dspl1236/TeensyEprom/schematics/audi90_teensy_v4.html

// ECU INTERFACE PROJECT · REV 0.4

# AUDI 90 2.6L STROKER // TEENSY 4.1

443 906 022 HITACHI · SPARTAN 3 LITE OEM + LSU ADV · PARALLEL BUS EMULATION + SENSOR EXPANSION

REV 0.4 — MAF STRATEGY UPDATE ▲ MAF: PHASE 1 FREQ INTERCEPT → PHASE 2 VW MK4 1.8T ANALOG ▲ HOUSING: VR6/225 70MM BILLET UNIT (SOURCING) ▲ FIRMWARE: DUAL-PHASE SENSOR-AGNOSTIC MAF ARCHITECTURE ▲ BOM: MAF SENSOR + HOUSING ADDED

Wiring Schematic

Power Regulation

Signal Intercepts

UART + Firmware

Breadboard Build

BOM + Buy Links

EPROM Bus → FlexIO

D0–D7Data bus (8-bit)Pins 2–9

A0–A7Address lowPins 10–17

A8–A15Address highPins 18–25

A16Address MSBPin 26

/OEOutput enablePin 27

/CEChip enablePin 28

LEVEL SHIFT: All 28 lines via 74HCT245 ×3. Data bus is bidirectional — DIR pin controlled by /OE state. Address + control lines are unidirectional ECU→Teensy.

Spartan 3 Lite OEM → SERIAL1 UPDATED

TXSpartan TX out (5V)10k/20k div → Teensy RX pin 0

RXSpartan RX in (5V)Teensy TX pin 1 direct ✓

12VController powerSwitched IGN + 5A fuse

HTR GNDLSU heater groundBattery − DEDICATED

SIG GNDSignal groundSignal GND rail

⚠ CRITICAL: LSU Heater GND must be wired before power-up. If the Spartan boots without heater ground connected it enters bootloader mode and will not stream lambda data.

Sensor ADC Inputs

ADC0FREE — oil/fuel pressurePin A0

ADC1MAP sensor (5V÷)Pin A1

ADC2Knock (AC bias)Pin A2

ADC3TPS (tee + 5V÷)Pin A3

ADC4IAT sensorPin A4

DIGRPM / coil triggerPin 30 IRQ

ADC0 NOW FREE: UART wideband frees the analog pin. Add a 150 PSI oil pressure sensor here — critical data for a built motor.

MAF Intercept — Phase 1 / Phase 2 NEW v0.4

Pin 20MAF signal INPh1: 7A freq interrupt · Ph2: 1.8T ADC (10k/20k÷)

Pin 21MAF freq OUT → ECUIntervalTimer PWM synthesis

Ph1 factor×1.130 displacement correction2.6L ÷ 2.3L — tune on dyno

Ph2 sensorBosch 0 280 218 037VW MK4 1.8T · analog 0–5V

Ph2 housingVR6 / Audi S4 225 billet 70mmSourcing now

Ph2 wiringPin 1=GND · Pin 2=12V · Pin 3=SignalSignal → 10k/20k÷ → Pin 20 ADC

PHASE SWITCH: Change MAF_INPUT_TYPE in config.h. MAF_INPUT_FREQUENCY = Phase 1 (now). MAF_INPUT_ANALOG = Phase 2 (turbo). No hardware changes needed — same pins, same output.

12V Input Protection

SourceIgnition switched 12V

Fuse5A blade, inline, weatherproof

TVSP6KE15A to GND — load dump clamp

Rev pol1N5822 Schottky in series

Bulk C470µF 25V electrolytic

5V Rail — LM2596 Module

ModulePre-built LM2596 adjustable buck

Set to5.00V exactly — measure with meter

Rated3A continuous output

Loads74HCT245 ×3 · MAP · TJA1051 ×2

Bypass0.1µF ceramic at every IC Vcc pin

3.3V Rail — AMS1117 LDO

Input5V rail from LM2596

RegAMS1117-3.3 SOT-223

In cap10µF tantalum + 0.1µF ceramic

Out cap10µF tantalum + 0.1µF ceramic

LoadTeensy VIN (has own internal reg)

Spartan 3 Lite Power — Separate! UPDATED

12V inSeparate switched IGN line

Fuse5A blade — Spartan draws up to 3A peak

HTR GNDDedicated wire → battery negative

SIG GNDTo signal GND rail at Teensy

Boot ruleHTR GND FIRST, then 12V — always

NEVER share the Spartan heater ground with engine block or signal ground. Heater draws 2A+ during warm-up — this creates massive noise if not isolated.

Power budget @ 5V rail: Teensy 4.1 ~250mA · 74HCT245 ×3 ~150mA · Sensors ~80mA · TJA1051 ×2 ~40mA · Misc ~50mA = ~570mA total. LM2596 rated 3A — comfortable 5× headroom. Spartan 3 Lite runs entirely on its own 12V line — does NOT load the 5V rail at all.

Injector Intercept

Cut ECU injector signal wire. ECU side → IRLZ44N drain. Injector → source. Teensy pin → 100Ω → gate.

Teensy monitors ECU's intended pulse on a digital input, re-fires gate with corrected pulse width referenced to Lambda, MAP, and RPM. Effective ±30% trim range.

1N4007 flyback across each injector is mandatory — coil collapse destroys the MOSFET without it. 100Ω gate resistor damps oscillation.

MAF Signal Architecture — Phase 1 / Phase 2 UPDATED

PHASE 1 — NOW (stock 7A hotwire sensor):
Teensy reads stock 7A MAF frequency on PIN_MAF_IN (interrupt). Multiplies by displacement factor (2.6L ÷ 2.3L = ×1.130). Synthesises corrected frequency on PIN_MAF_OUT via IntervalTimer PWM → ECU reads corrected airflow. One #define to adjust factor after dyno tuning.

PHASE 2 — TURBO INSTALL (VW MK4 1.8T hot film):
Bosch 0 280 218 037 analog 0–5V sensor in VR6/225 70mm billet housing. Teensy reads analog voltage on ADC → kg/h via 1.8T cal table → equivalent 7A ECU frequency via 7A cal table → synthesised on PIN_MAF_OUT. Backflow immune, oil tolerant, rated ~480 kg/h.

Switching phases = one line in config.h. All calibration tables are firmware-side — no hardware change required between Phase 1 and Phase 2 except physical sensor swap.

⚠ Phase 2 pre-req: Log stock 7A MAF frequency vs RPM/load with oscilloscope before enabling Phase 2. Verify 7A frequency table values match measured data.

UART Lambda — LSU ADV ADV

Spartan streams Lambda data continuously at 9600 baud. Teensy reads it asynchronously on Serial1 — no polling delay, no blocking.

The LSU ADV's 20× resolution improvement means the PID loop sees finer grain AFR error. At stoichiometric (λ=1.0) the ADV resolves ~0.0005λ vs ~0.01λ for the 4.9. That granularity directly improves closed-loop correction stability.

No calibration ever required — sensor manufactured to tolerance, no trim resistor needed.

Knock Sensor Signal Conditioning

Knock sensor outputs AC voltage centered at 0V. Teensy ADC is 0–3.3V only — negative voltage will damage it.

Required conditioning:
• 0.1µF coupling cap in series (blocks DC)
• Two 100kΩ to form 1.65V bias (3.3V ÷ 2)
• Signal biased to 1.65V center — safely in ADC range
• 100pF cap to GND for RF noise filtering

At 600MHz, Teensy runs real-time FFT on the knock signal sampled at ~100kHz. Knock frequency on the 2.3/2.6 inline-5 is typically 6–9kHz.

When FFT energy at knock frequency exceeds threshold, Teensy writes modified timing data to the EPROM emulation layer — pulling 1–3° per cycle until knock subsides. Recovery ramp adds timing back at 0.5°/cycle.

Far more precise than the stock Hitachi knock threshold logic.

UART VOLTAGE MISMATCH: Spartan 3 Lite OEM TX pin outputs 5V logic. Teensy 4.1 RX pins are 3.3V tolerant only. A simple 10kΩ/20kΩ voltage divider on the Spartan TX → Teensy RX line is required. Teensy TX → Spartan RX is fine direct — 3.3V reads as logic high on 5V UART input.

UART Wiring — Spartan 3 Lite OEM ↔ Teensy 4.1

Spartan TX→ 10kΩ → Teensy RX (pin 0)+ 20kΩ to GND

Teensy TX→ Spartan RX direct3.3V → 5V RX ✓

Spartan GNDSignal GND at TeensyNOT engine block

Spartan HTR GNDBattery negative directDedicated wire!

Spartan 12VSwitched IGN + 5A fuseSeparate from Teensy rail

BAUD RATE: 9600 · 8 data bits · 1 stop bit · no parity · no flow control. This is confirmed from the official Spartan 3 Lite OEM datasheet.

LSU ADV — Sensor Install Notes

BungM18×1.5 weld-in bung10–2 o'clock position

PositionMax 60° from verticalPrevents water trap

Location~2ft from exhaust portBefore any cat

Warm-upSmart heatup — waits 350°CNo thermal shock

No CALNo free air calibration neededADV is factory precise

CONFIG: Order Spartan 3 Lite OEM from 14point7.com and in the order notes specify "configure for LSU ADV sensor" — otherwise it ships set for LSU 4.9 and needs UART reconfiguration.

Teensy Firmware — UART Lambda Reader

// Spartan 3 Lite OEM — UART Lambda on Teensy 4.1 Serial1 // 9600 baud, 8N1, 5V TX → 10k/20k divider → Teensy pin 0 (RX) #include <Arduino.h> float currentLambda = 1.0; float targetLambda = 1.0; // set from RPM/MAP table bool sensorReady = false; uint32_t lastLambdaMs = 0; String uartBuffer = ""; void setupWideband() { Serial1.begin(9600); // Teensy pin 0=RX, 1=TX Serial1.print("G"); // request data stream } void readWideband() { while (Serial1.available()) { char c = Serial1.read(); if (c == '\r' || c == '\n') { if (uartBuffer.length() > 0) { parseSpartanFrame(uartBuffer); uartBuffer = ""; } } else { uartBuffer += c; } } } void parseSpartanFrame(String frame) { // Spartan 3 format: "L:XXXXX" where XXXXX / 10000.0 = Lambda if (frame.startsWith("L:")) { float raw = frame.substring(2).toFloat(); currentLambda = raw / 10000.0; sensorReady = true; lastLambdaMs = millis(); } } bool lambdaValid() { // stale data check — sensor should update every 10ms return sensorReady && (millis() - lastLambdaMs < 500); }

NOTE: The exact Spartan 3 Lite OEM serial frame format should be verified against the official manual from 14point7.com before finalising firmware. The format above reflects documented Spartan 3 behaviour — confirm with the OEM variant manual linked on their docs page.

BUILD PHILOSOPHY: Each stage is independently testable. Never connect an untested stage to the ECU. Confirm each step with a multimeter or logic analyzer before proceeding. The breadboard prototype validates everything before PCB layout begins.

00

### EPROM DUMP — ABSOLUTE FIRST STEP

Before touching anything else, remove the EPROM from the ECU and read it with a TL866II+ or T48 programmer. Save the binary to at least two locations (USB + cloud). This is your recovery file. If the Teensy has a bug and the ECU won't boot, you reflash the original. No exceptions — do this before Stage 01.

01

### POWER STAGE — BENCH ONLY

Build LM2596 module + AMS1117 on breadboard. Apply 12V from bench supply. Measure: 5.00V ±0.05V on 5V rail, 3.30V ±0.05V on 3.3V rail. Plug Teensy into 3.3V/5V rails, confirm USB enumeration on laptop. Install Arduino IDE + Teensyduino, flash blink sketch. Solid foundation confirmed.

02

### SPARTAN 3 LITE OEM — UART BENCH TEST

Wire Spartan TX → 10kΩ → Teensy RX pin 0, with 20kΩ from that junction to GND. Wire Teensy TX pin 1 → Spartan RX direct. Connect Spartan HTR GND to bench PSU negative before connecting 12V. Confirm Lambda data appears on Serial Monitor at 9600 baud. With sensor in free air expect ~1.0λ or slightly lean. No data = check HTR GND wiring first.

03

### LEVEL SHIFTERS — BENCH TEST

Wire 74HCT245 ×3 between ZIF socket and Teensy FlexIO pins. Load firmware that serves the original EPROM binary from flash. Use logic analyzer on address/data lines — verify Teensy responds to reads within 150ns timing window. Vary address lines with signal generator, confirm correct data returned. No ECU connected yet.

04

### SENSOR INPUTS — BENCH TEST

Wire GM 3-bar MAP through 10kΩ/20kΩ divider to ADC1. Apply 5V to MAP Vcc. Vary vacuum port — confirm ADC readings change. Build knock bias circuit: 100kΩ/100kΩ voltage divider for 1.65V, 0.1µF coupling cap, 100pF RF filter. Confirm ADC2 reads ~1.65V at rest with no knock signal. Wire TPS and IAT tee-offs through dividers, confirm readings.

05

### INJECTOR MOSFET STAGE — BENCH TEST

Wire IRLZ44N gates to Teensy D2–D5 via 100Ω gate resistors. Use a 12V LED as injector load substitute. Generate test pulse from Teensy — confirm gate switching with oscilloscope. Verify clean switching with no ringing. Confirm 1N4007 flyback correctly placed (cathode to 12V rail). Test pulse width trimming by varying gate delay in firmware — verify on scope.

06

### FIRST ECU CONNECTION — ENGINE OFF

Install ZIF socket in ECU (original EPROM removed). Connect breadboard via ribbon cable through level shifters. Disconnect fuel pump relay first. Ignition on — logic analyzer should show ECU initiating address reads within milliseconds. Teensy responds with EPROM image data. Verify no address mismatches. No smoke = proceed.

07

### FIRST START — EPROM EMULATION ONLY

Restore fuel pump relay. Start engine with Teensy serving stock EPROM image — zero corrections active. Engine should run identically to before. If it doesn't start or runs rough, EPROM emulation has a timing issue — return to bench. Once confirmed running normally, the foundation is solid. All correction layers added incrementally from here.

08

### WIDEBAND + CLOSED LOOP — ACTIVATE

With engine running, enable Lambda reading from Spartan via UART. Datalog AFR vs RPM/MAP for a full drive cycle in open loop (no correction active) to understand where the stock tune is rich/lean on the 2.6L. Then enable injector trim with conservative ±10% limit. Expand limits once behavior is understood. This is where the 20× ADV resolution starts earning its keep.

09

### PCB LAYOUT — WHEN BREADBOARD IS PROVEN

Open KiCad (free). Transfer schematic from breadboard to KiCad schematic editor. Layout PCB with Teensy on removable pin headers, 74HCT245 in DIP sockets, LM2596 as plug-in sub-module, screw terminals for all external connections. Keep analog GND and digital GND separated with a single tie point. Submit to JLCPCB — 5 boards, 2-layer, ENIG finish for kit quality. ~$10 + shipping, ~10 day turnaround.

Sourcing: Amazon links for most components. Wideband + LSU ADV sensor from 14point7.com direct — specify "configure for LSU ADV" in order notes. PCB production via JLCPCB when ready.

Ref | Component | Specification | Qty | Est. USD
── MICROCONTROLLER
U1 | Teensy 4.1 (with pins) PJRC — 600MHz ARM M7, 8× UART, FlexIO, 18× ADC, built-in SD, USB HS, 3× CAN FD ▶ AMAZON (https://www.amazon.com/PJRC-Teensy-4-1-with-Pins/dp/B08CTM3279) | NXP iMXRT1062 · 1MB RAM · 8MB flash · 55 I/O pins | 1 | ~$35
── WIDEBAND — ORDER FROM 14POINT7.COM DIRECT UPDATED
WB1 | Spartan 3 Lite OEM REPLACES SPARTAN 2 OEM I2C UART output · 9600 baud 8N1 · 5V logic · 10ms response · LSU ADV compatible · specify "configure for LSU ADV" in order notes ▶ 14POINT7.COM (https://www.14point7.com/products/spartan-3-lite-oem) | 0.01λ accuracy · -40 to +125°C · UART + analog output · water resistant · 2yr warranty | 1 | $35.00
WB2 | Bosch LSU ADV Wideband Sensor ADV — 20× RESOLUTION 14Point7 branded — genuine Bosch ADV internals. No trim resistor. No calibration needed. 5-pin connector (vs 6-pin on LSU 4.9) ▶ 14POINT7.COM (https://www.14point7.com/products/bosch-lsu-4-9) | Linear element design · faster light-off · wider temp range · M18×1.5 thread · 5-pin connector | 1 | ~$75
WB3 | M18×1.5 Weld-In Exhaust Bung Weld into exhaust 2ft from exhaust port, 10–2 o'clock position, max 60° from vertical ▶ AMAZON SEARCH (https://www.amazon.com/s?k=M18+x+1.5+weld+bung+oxygen+sensor) | Stainless steel, M18×1.5 thread, with plug — weld before sensor install | 1 | ~$8
── LEVEL SHIFTING
U2–U4 | 74HCT245 Octal Bus Transceiver DIP-20 Major Brands — confirmed working with Teensy. Buy 5, use 3. Avoid Todiys brand (reported failures with Teensy) ▶ AMAZON — MAJOR BRANDS (https://www.amazon.com/Tri-State-Octal-Bus-Transceiver/dp/B00GAGAZDA) | 5V Vcc · 3.3V-compatible inputs · 3-state outputs · DIP-20 · 8-bit bidirectional | 5 | ~$6
── UART VOLTAGE DIVIDER (NEW — SPARTAN TX → TEENSY RX)
R1, R2 | 10kΩ + 20kΩ Resistors — UART Level Divider 10kΩ in series on Spartan TX line, 20kΩ from junction to GND. Divides 5V → 3.3V for Teensy RX input ▶ AMAZON — RESISTOR KIT (https://www.amazon.com/s?k=resistor+kit+assortment+1%25+metal+film) | 1% metal film · 1/4W · from resistor kit | 2 | incl.
── SENSORS
S1 | GM 3-Bar MAP Sensor with Pigtail OEM # 55567257 (replacement for discontinued 12592525) — with connector pigtail. Reads to 44 PSI ▶ AMAZON (https://www.amazon.com/Sensor-Various-Models-Connector-Pigtail/dp/B07TJG9F6L) | 0–5V output · 3-bar range · Bosch internals · 3-wire sensor (Vcc / GND / signal) | 1 | ~$20
S2 | Bosch Knock Sensor 0261231006 Flat donut type — check if already present on 7A block before ordering. M8×1.25 mount ▶ AMAZON (https://www.amazon.com/Bosch-Original-Equipment-0261231006-Sensor/dp/B00BHHYVHS) | Broadband piezo · flat type · M8 thread · AC output signal | 1 | ~$28
MAF1 | VW MK4 1.8T MAF Sensor — Bosch 0 280 218 037 NEW v0.4 Phase 2 MAF sensor. Hot film element, analog 0–5V output, 3-pin connector. Backflow immune, oil tolerant. Part fits Golf/Jetta/Beetle 1.8T MK4. Confirm 3-pin analog variant — NOT the frequency output type ▶ AMAZON SEARCH (https://www.amazon.com/s?k=Bosch+0+280+218+037+MAF+sensor) | Analog 0–5V · 3-pin · hot film · ~480 kg/h max · Bosch OEM quality | 1 | ~$40–60
MAF2 | VR6 / Audi S4 225 70mm MAF Housing — Billet NEW v0.4 Sourcing now. 70mm bore billet aluminium housing to accept MK4 1.8T MAF element. VR6 or Audi 2.7T S4 225 housings are commonly used with MK4 1.8T element transplant for high-flow applications. Check eBay / VAG forums for used OEM or billet aftermarket unit. Confirm element mounting diameter matches Bosch 0 280 218 037 ▶ EBAY SEARCH (https://www.ebay.com/sch/i.html?_nkw=VR6+MAF+housing+70mm) | 70mm bore · accepts MK4 1.8T element · pre-turbo position · 10× pipe diameters straight run upstream | 1 | ~$30–80
── INJECTOR INTERCEPT
Q1–Q4 | IRLZ44N Logic-Level MOSFET (10-pack) Logic-level gate threshold ~1V — fully saturates at 3.3V. Need 4, buy 10 for spares ▶ AMAZON (https://www.amazon.com/5PCS-IRLZ44NPBF-MOSFET-220AB-IRLZ44/dp/B01ARKPMPK) | N-ch · 55V · 47A · TO-220 · Vgs(th) ~1V · fully on at 3.3V gate | 1pk | ~$6
D1–D4 | 1N4007 Flyback Diodes (100-pack) Across each injector coil — absolutely mandatory. Coil collapse destroys MOSFET without protection ▶ AMAZON SEARCH (https://www.amazon.com/s?k=1N4007+diode+100+pack) | 1A · 1000V · DO-41 · reverse biased across injector | 1pk | ~$3
── CAN BUS
U5–U6 | TJA1051T CAN Transceiver Module (breakout) NXP TJA1051 on breakout board — 3.3V compatible, 1Mbit/s, breadboard-friendly for prototype ▶ AMAZON (https://www.amazon.com/Pcs-TJA1051T-CAN-Transceiver-Module/dp/B0G4KC3NDY) | 3V–5V logic · 1Mbps · NXP TJA1051 · breakout with screw terminals | 2 | ~$8
── POWER REGULATION
U7 | LM2596 Buck Converter Module with Display (5-pack) Pre-built module with LED voltmeter — set to exactly 5.00V before connecting anything ▶ AMAZON (https://www.amazon.com/LM2596-Converter-3-0-40V-1-5-35V-Supply/dp/B08NV3JCBC) | 3–40V in · 1.5–35V adjustable out · 3A · onboard voltmeter display | 1pk | ~$10
U8 | AMS1117-3.3 LDO Regulator (10-pack) SOT-223 package. Input from 5V LM2596 rail → Teensy VIN ▶ AMAZON SEARCH (https://www.amazon.com/s?k=AMS1117+3.3+SOT-223) | 1A output · 1.3V dropout · SOT-223 package | 1pk | ~$4
D5 | P6KE15A TVS Diode Automotive load-dump spike protection on 12V input — not optional in a vehicle ▶ AMAZON SEARCH (https://www.amazon.com/s?k=P6KE15A+TVS+diode) | 600W transient · 15V clamp · DO-15 · bidirectional | 5 | ~$3
D6 | 1N5822 Schottky Diode 3A (10-pack) Reverse polarity protection in series on 12V input rail ▶ AMAZON SEARCH (https://www.amazon.com/s?k=1N5822+schottky+3A) | 40V · 3A · Schottky · low forward voltage drop | 1pk | ~$3
── EPROM SOCKET + PROGRAMMER
J1 | 28-Pin ZIF Socket (5-pack) Installs in ECU in place of original EPROM. ZIF lever allows easy insertion of Teensy ribbon connector ▶ AMAZON (https://www.amazon.com/28-pin-Pins-Universal-Socket-Narrow/dp/B01N3P502V) | Narrow DIP-28 · 2.54mm pitch · zero insertion force · gold contacts | 1pk | ~$8
PROG | TL866II+ / T48 Universal EPROM Programmer Read original EPROM before touching anything. This is your safety net — do not skip ▶ AMAZON SEARCH (https://www.amazon.com/s?k=TL866II+programmer) | Supports TC537000P and all common EPROM types · USB to PC · includes adapters | 1 | ~$35
── PASSIVES + PROTOTYPING
C-KIT | Capacitor Assortment ▶ AMAZON SEARCH (https://www.amazon.com/s?k=capacitor+assortment+electrolytic+ceramic+tantalum) | 470µF/25V · 100µF/25V · 10µF tantalum · 0.1µF ceramic · 100pF ceramic | 1 kit | ~$8
R-KIT | Resistor Assortment Kit (600pc) ▶ AMAZON SEARCH (https://www.amazon.com/s?k=resistor+assortment+600+pieces+metal+film) | 10kΩ · 20kΩ · 100kΩ · 100Ω · 1kΩ — needed for dividers, gate R, knock bias | 1 kit | ~$8
BB | 830-Point Breadboards (2-pack) ▶ AMAZON SEARCH (https://www.amazon.com/s?k=830+breadboard+2+pack) | Full size · 830 tie points · for complete prototype build | 1pk | ~$8
WIRE | Jumper Wire Kit 120pc (M-M, M-F, F-F) ▶ AMAZON SEARCH (https://www.amazon.com/s?k=dupont+jumper+wire+120+male+female+assortment) | Dupont 2.54mm · assorted lengths · all three types | 1 kit | ~$7
FUSE | Weatherproof Inline Blade Fuse Holders + Fuses Need two: one for main 12V Teensy rail (5A), one for Spartan 12V line (5A) ▶ AMAZON SEARCH (https://www.amazon.com/s?k=waterproof+inline+blade+fuse+holder+automotive+5A) | ATO blade type · 12V rated · waterproof housing | 2 | ~$6
── PCB (AFTER PROTOTYPE VALIDATED)
PCB | Custom 2-Layer PCB via JLCPCB Design in KiCad (free). 5 boards, 2-layer, ENIG finish for kit quality. ~80×70mm target size ▶ JLCPCB.COM | 2-layer · ENIG · black soldermask (kit aesthetic) · M3 mounting holes · ~10 day lead | 5 | ~$10
ESTIMATED TOTAL — excl. wideband system parts only | | | | ~$200
WIDEBAND SYSTEM — Spartan 3 Lite OEM + LSU ADV ADV SENSOR | | | | ~$110
MAF SYSTEM — Bosch 1.8T sensor + VR6/225 housing NEW v0.4 | | | | ~$70–140
FULL PROTOTYPE TOTAL — everything included complete | | | | ~$380–470
MAF system is Phase 2 / turbo install — not required for initial Phase 1 breadboard build. Phase 1 runs with stock 7A MAF sensor already on the car. | | | | ✓ PHASE 1 = NO EXTRA COST
