dspl1236/TeensyEprom/schematics/audi90_teensy_schematic.html

ECU Interface Project // Rev 0.1

# AUDI 90 2.6L STROKER // TEENSY 4.1

443 906 022 HITACHI ECU — PARALLEL BUS EMULATION + SENSOR EXPANSION

7A/NF BLOCK // AAF CRANK // CCTA RODS

2.3 → 2.6L // 95.6mm STROKE

Wiring Schematic

Power Regulation

Signal Intercepts

Parts List

EPROM Parallel Bus → Teensy FlexIO

D0–D7 Data bus (8-bit) T4.1 pins 2–9

A0–A7 Address low byte T4.1 pins 10–17

A8–A15 Address high byte T4.1 pins 18–25

A16 Address MSB T4.1 pin 26

/OE Output enable T4.1 pin 27

/CE Chip enable T4.1 pin 28

NOTE: All lines pass through 74HCT245 level shifters. Direction pin (DIR) tied HIGH for ECU→Teensy on address lines, bidirectional logic needed on data lines.

Sensor Inputs → Teensy ADC

ADC0 Wideband O2 (0–5V) Pin A0 + 10k/20k div

ADC1 MAP sensor (0–5V) Pin A1 + 10k/20k div

ADC2 Knock sensor (AC) Pin A2 + filter circuit

ADC3 TPS (tee off) Pin A3 + 10k/20k div

ADC4 IAT sensor Pin A4 + 10k/20k div

DIG RPM / coil trigger Pin 30 interrupt

NOTE: Teensy ADC is 3.3V max. All 5V sensor signals need a voltage divider (10kΩ + 20kΩ to GND). Knock signal needs AC coupling cap + half-wave bias.

Signal Outputs / Intercepts

D2 Injector 1 gate IRLZ44N gate

D3 Injector 2 gate IRLZ44N gate

D4 Injector 3 gate IRLZ44N gate

D5 Injector 4 gate IRLZ44N gate

D6 MAF signal synthetic RC filter → ECU pin

CAN1 OBD2 CAN H/L TCAN1051 transceiver

USB Live tune / log USB-C to laptop

12V Input Stage

Source Switched 12V (IGN)

Spike protection P6KE15A TVS diode

Reverse polarity 1N5822 Schottky diode

Bulk cap 470µF 25V electrolytic

Fuse 3A blade fuse inline

5V Rail — LM2596 Buck

Regulator LM2596-5.0 (fixed)

Input cap 100µF 25V

Output cap 220µF 10V low-ESR

Inductor 68µH (LM2596 datasheet)

Catch diode 1N5822 Schottky 3A

Load 74HCT245 × 3, sensors

Bypass 0.1µF ceramic per IC

3.3V Rail — AMS1117 LDO

Input 5V rail (from LM2596)

Regulator AMS1117-3.3 SOT-223

Input cap 10µF tantalum

Output cap 10µF tantalum

Note Teensy has own reg

Bypass 0.1µF per logic IC

Grounding Strategy

Signal GND Single point at ECU GND

Power GND Battery negative direct

Sensor GND Tied to signal GND

Wideband GND Dedicated — avoid loops

Knock shield GND at one end only

CRITICAL: Do NOT connect wideband controller ground to engine block. Run a dedicated ground wire to battery negative to avoid noise on the O2 signal.

Power budget estimate: Teensy 4.1 at full load ~250mA @ 3.3V · 74HCT245 × 3 ~150mA @ 5V · Sensors ~100mA · MOSFET gates ~50mA · Total ≈ 550mA @ 5V. LM2596 rated 3A — comfortable margin. Automotive 12V can spike to 16V+ during load dump — TVS diode is not optional.

## Signal Intercept Points

Injector Signal Intercept

ECU injector output wire is cut. ECU side connects to IRLZ44N drain. Source connects to injector. Teensy controls gate.

When Teensy gate is HIGH, injector fires normally. Teensy can shorten or extend the pulse by controlling gate timing relative to ECU signal.

Trim range: ~±30% pulse width
A flyback diode (1N4007) across each injector is required.

MAF Signal Synthesis

The stock MAF outputs a frequency signal (not analog voltage) on most VAG units of this era. Teensy reads the original MAF frequency on an interrupt pin, applies a correction factor based on MAP + wideband data, and outputs a corrected frequency to the ECU.

This "lies" to the ECU about airflow, effectively re-scaling the fueling for the larger 2.6L displacement.

Confirm MAF signal type (freq vs voltage) before implementing.

EPROM Bus Intercept

The original EPROM chip is removed from its socket. A ribbon cable connects the 28-pin socket to the level shifters, then to the Teensy FlexIO pins.

Teensy responds to every address read with data from its internal flash — effectively acting as a faster, smarter EPROM.

Access time target: <150ns — easily achievable at 600MHz.

Maps stored in Teensy flash can be updated over USB without opening ECU.

Knock sensor signal conditioning: The Bosch knock sensor outputs a small AC voltage centered around 0V. Teensy ADC cannot handle negative voltages. Add a 0.1µF coupling capacitor in series and a 100kΩ resistor to 1.65V (half of 3.3V using a voltage divider) to bias the signal into the safe 0–3.3V range. The Teensy's 600MHz M7 can then run FFT on this signal to isolate the knock frequency (~6–8kHz for these engines).

## Complete Parts List

Ref | Component | Spec / Part # | Qty | Est. USD
── MICROCONTROLLER
U1 | Teensy 4.1 PJRC — main controller | 600MHz ARM Cortex-M7, 1MB RAM, built-in SD, USB HS | 1 | $29.85
── LEVEL SHIFTING
U2–U4 | 74HCT245 Octal Bus Transceiver 5V↔3.3V, parallel bus | DIP-20 or SOIC-20, 5V supply, 3.3V compatible inputs | 3 | $1.20
── SENSORS
S1 | AEM 30-0300 Wideband UEGO Controller + Bosch LSU 4.9 sensor | 0–5V linear AFR output, includes bung for exhaust | 1 | $189.00
S2 | GM 3-Bar MAP Sensor Part # 12592525 or 16040749 | 0–5V, 10–304 kPa, Delphi connector, cheap and universal | 1 | $18.00
S3 | Bosch Knock Sensor 0 261 231 006 | Flat type, M8 thread, broadband piezo — may already be on block | 1 | $22.00
── INJECTOR INTERCEPT
Q1–Q4 | IRLZ44N Logic-Level MOSFET Injector pulse width control | N-ch, 55V 47A, Vgs(th) 1V — fully on at 3.3V gate | 4 | $4.80
D1–D4 | 1N4007 Flyback Diode Injector coil protection | 1A 1000V — across each injector | 4 | $0.40
── CAN BUS
U5–U6 | TCAN1051 CAN Transceiver Texas Instruments | 3.3V, 5Mbps CAN FD, automotive grade, SOIC-8 | 2 | $3.60
R1–R2 | 120Ω CAN Termination Resistor | 1/4W, one per CAN bus end | 2 | $0.20
── POWER REGULATION
U7 | LM2596-5.0 Buck Regulator Fixed 5V output | 3A output, 12V input, TO-263 / D2PAK | 1 | $1.50
U8 | AMS1117-3.3 LDO Regulator | 1A, SOT-223, input from 5V rail | 1 | $0.50
L1 | 68µH Power Inductor For LM2596 buck circuit | 3A rated, radial or SMD | 1 | $1.20
D5 | 1N5822 Schottky Diode 3A Buck catch diode + reverse polarity | 40V 3A Schottky | 2 | $0.60
D6 | P6KE15A TVS Diode 12V input spike suppression | 600W transient, 15V clamp — automotive essential | 1 | $0.80
── PASSIVES / SUPPORTING
C1–C10 | Capacitor Assortment | 100µF 25V electro, 10µF tantalum, 0.1µF ceramic (×10) | 1 kit | $5.00
R-KIT | Resistor Assortment | 10kΩ, 20kΩ, 100kΩ, 1kΩ (voltage dividers, pull-ups, bias) | 1 kit | $3.00
J1 | 28-Pin DIP ZIF Socket EPROM socket replacement in ECU | Zero insertion force, fits TC537000P footprint | 1 | $3.50
CABLE | 28-conductor Ribbon Cable | 0.05" pitch IDC, ~30cm — ECU socket to level shifters | 1 | $4.00
PCB | Proto PCB or Custom PCB Recommend JLCPCB 2-layer | ~80×60mm, fits level shifters + power stage + connectors | 1 | $8.00
CONN | Automotive Connectors / Housing | Deutsch DT series or Molex Mini-Fit Jr — weatherproof | 1 kit | $15.00
FUSE | Inline Blade Fuse Holder + 3A Fuse | Waterproof, 12V — on power input wire | 1 | $3.00
ESTIMATED TOTAL excl. wideband | | | | ~$125
ESTIMATED TOTAL incl. wideband | | | | ~$315

Sourcing notes: Teensy 4.1 — buy direct from PJRC.com (supports the developer). AEM wideband — Amazon or Summit Racing. GM MAP sensor — RockAuto or eBay (OEM Delphi). 74HCT245 / TCAN1051 / LM2596 — Mouser, Digi-Key, or LCSC. IRLZ44N MOSFETs — Digi-Key or AliExpress in bulk. Connectors — Waytek Wire or Del City for proper automotive Deutsch connectors.
