dspl1236/TeensyEprom/schematics/audi90_teensy_v2.html

ECU INTERFACE PROJECT // REV 0.2

# AUDI 90 2.6L STROKER // TEENSY 4.1

HITACHI 443 906 022 · SPARTAN 2 OEM I2C · PARALLEL BUS EMULATION

REV 0.2 — UPDATED BOM

7A/NF BLOCK // AAF CRANK 95.6mm // CCTA RODS+PISTONS

Wiring Schematic

Power Regulation

Signal Intercepts

Breadboard Prototype

Parts List + Buy Links

EPROM Bus → Teensy FlexIO

D0–D7Data busPins 2–9

A0–A7Address lowPins 10–17

A8–A15Address highPins 18–25

A16Address MSBPin 26

/OEOutput enablePin 27

/CEChip enablePin 28

NOTE: Via 74HCT245 level shifters. 3× chips needed: data bus bidirectional, address lines A+B unidirectional.

Spartan 2 OEM I2C → Teensy

SDAI2C DataTeensy pin 18

SCLI2C ClockTeensy pin 19

12VPower inSwitched IGN + fuse

GNDGroundDedicated batt −

ADDRI2C addressDefault 0x01

UPGRADE NOTE: 14point7 recommends Spartan 3 Lite OEM for new designs — also $35 and adds analog output as backup. Worth considering.

Sensor ADC Inputs

ADC1MAP sensor (5V÷)Pin A1

ADC2Knock (AC bias)Pin A2

ADC3TPS (tee + 5V÷)Pin A3

ADC4IAT sensorPin A4

DIGRPM / coilPin 30 IRQ

WIDEBAND FREE: ADC0 now free since Spartan uses I2C. Can use for oil pressure, fuel pressure, or EGT.

12V Input Protection Stage

SourceIgnition switched 12V

Fuse5A blade, inline, weatherproof

Spike clampP6KE15A TVS diode to GND

Reverse polarity1N5822 Schottky in series

Bulk cap470µF 25V electrolytic

WHY TVS: Automotive 12V can spike to 60V+ during load dump events (alternator disconnect). The P6KE15A clamps at 15V and absorbs the spike before it reaches any silicon.

5V Rail — LM2596 Module

ModulePre-built LM2596 buck module

Input12V protected rail

Output setTrim pot to 5.00V (multimeter)

Rated output3A continuous

Loads74HCT245 ×3, MAP, TJA1051

Bypass0.1µF ceramic at each IC Vcc

BREADBOARD TIP: Use a pre-built LM2596 module for prototype — set output to exactly 5.00V before connecting anything. Measure twice.

3.3V Rail — AMS1117 LDO

Input5V rail from LM2596

RegulatorAMS1117-3.3 (SOT-223)

Input cap10µF tantalum + 0.1µF ceramic

Output cap10µF tantalum + 0.1µF ceramic

LoadTeensy VIN (Teensy has own reg)

Headroom1.7V dropout — adequate from 5V

Grounding — Critical!

Star pointECU chassis GND

Power GNDDirect to battery −

Signal GNDTied to star at one point

Wideband GNDDEDICATED — battery − only

Knock shieldGND at Teensy end only

MAP GNDSignal GND rail

CRITICAL: Never share wideband controller ground with engine block. Separate wire all the way to battery. Ground loops destroy wideband accuracy.

Power budget @ 12V input / 5V rail: Teensy 4.1 ~250mA · 74HCT245 ×3 ~150mA · Sensors (MAP, TPS, IAT) ~60mA · TJA1051 ×2 ~40mA · Miscellaneous ~50mA · Total ≈ 550mA @ 5V. LM2596 rated 3A — 5× headroom. Spartan 2 OEM draws up to 3A @ 12V separately for sensor heating — it runs from its own 12V direct line with its own inline fuse.

Injector Signal Intercept

Cut ECU injector output wire. ECU side → IRLZ44N drain. Injector → IRLZ44N source. Teensy GPIO → gate via 100Ω resistor.

Teensy reads ECU's intended pulse timing on a digital input, then re-fires the MOSFET gate with corrected pulse width. Result: ±30% injector trim, wideband-referenced, RPM and MAP aware.

1N4007 flyback across each injector is mandatory — injector coil collapse will destroy the MOSFET without it.

MAF Signal Synthesis

Stock Hitachi MAF on the 7A/NF outputs a frequency signal (Hz proportional to airflow), not a DC voltage. Verify this with a scope before assuming.

Teensy reads original MAF freq on interrupt pin → scales it by a correction factor derived from MAP + displacement ratio (2.6L vs 2.3L stock) → outputs corrected frequency to ECU MAF input pin.

The ECU is "told" the engine is smaller than it is, causing it to request less fuel. The injector trim layer then adds the correct fuel back based on wideband feedback.

Spartan I2C Integration

The Spartan 2 OEM I2C puts Lambda data directly on the I2C bus. Teensy polls it at ~10ms intervals — faster than the sensor's 150ms response time, so no data is ever missed.

Wire.requestFrom(0x01, 2) — returns a 16-bit integer. Divide by 10000.0 to get Lambda float.

Compare to target Lambda table (indexed by RPM + MAP load), compute error, feed to injector trim PID loop. This is clean closed-loop fueling with zero analog noise.

ADC0 is now free — use for oil pressure or flex fuel sensor.

Knock Sensor Signal Conditioning

The Bosch knock sensor outputs a small AC voltage centered around 0V. Teensy ADC cannot handle negative voltages (0–3.3V only).

Required circuit:
• 0.1µF coupling cap in series (blocks DC)
• 100kΩ from signal to 1.65V bias voltage
• 1.65V from two 100kΩ resistors in series (3.3V divider)
• 100pF cap to GND for RF filtering

At 600MHz, Teensy can run a real-time FFT on the knock signal sampled at ~100kHz. Knock frequencies for the 2.3/2.6 5-cylinder are typically 6–9kHz.

When FFT energy at the knock frequency exceeds threshold, Teensy writes a modified ignition map entry via the EPROM emulation layer, pulling 1–3° of timing until knock subsides.

This is genuinely better than the stock ECU's crude knock threshold.

BUILD ORDER: Build and test each stage independently before connecting to the ECU. Never connect an untested module to the ECU. Stage 1 → bench test. Stage 2 → bench test. Stage 3 → engine off test. Stage 4 → running test.

What You Need for Breadboard Prototype

BREADBOARD ESSENTIALS

2× large 830-point breadboards
Jumper wire kit (M-M, M-F)
Bench power supply (12V, 5V, GND)
Multimeter
USB-C cable to laptop
Arduino IDE + Teensyduino

TEST EQUIPMENT (NICE TO HAVE)

Logic analyzer (Saleae or clone)
Oscilloscope (even a cheap DSO)
EPROM programmer (backup read)
CAN bus analyzer dongle
Wideband display / laptop

PCB DESIGN (LATER)

KiCad (free) for schematic/PCB
JLCPCB — 5 boards ~$8 shipped
Target: ~80×60mm 2-layer
All DIP components for kit-ability
Screw terminals for all connections

BUILD SEQUENCE

01

### EPROM DUMP — DO THIS FIRST

Before touching anything, read the original EPROM out of the ECU with a TL866II+ or T48 programmer. This is your golden backup. If anything goes wrong, you reflash the original. Do not skip this step. Save the binary file somewhere safe — cloud backup, multiple USB drives.

02

### POWER STAGE — BENCH TEST

Build the LM2596 module + AMS1117 circuit on a breadboard. Connect 12V bench supply. Measure output before connecting anything. You want exactly 5.00V ±0.05V and 3.30V ±0.05V. Add 0.1µF ceramics at Teensy VIN and GND. Power the Teensy. It should enumerate as USB device on your laptop.

03

### EPROM EMULATOR — BENCH TEST

Wire the 74HCT245 level shifters between the ZIF socket and Teensy FlexIO pins. Load test firmware that simply serves the original EPROM binary from Teensy flash. Insert ZIF into a spare ECU socket (or use a test jig). With a logic analyzer, verify the Teensy is responding to address reads correctly at the right timing. Do NOT connect to the car ECU until this passes.

04

### SPARTAN WIDEBAND — BENCH TEST

Wire Spartan 2 OEM I2C SDA/SCL to Teensy pins 18/19. Power Spartan from 12V (with its own inline fuse). Install the bung in the exhaust before this step — it needs to be in exhaust gas to read correctly. Run the I2C scanner sketch to confirm it appears at 0x01. Then test Lambda readback — with sensor in free air you should see ~1.0 Lambda or slightly lean.

05

### SENSOR INPUTS — BENCH TEST

Wire GM 3-bar MAP sensor through the 10k/20k voltage divider to ADC1. Apply 5V to MAP sensor Vcc. Vary the vacuum/pressure port (use your mouth or a hand pump) and verify ADC readings change sensibly. Repeat for knock signal conditioning circuit — verify bias voltage is sitting at 1.65V with no signal applied.

06

### INJECTOR MOSFET INTERCEPT — BENCH TEST

Wire IRLZ44N gates to Teensy D2–D5. Connect a 12V LED (or bench injector) as the load. Simulate ECU injector signals with a signal generator or Teensy itself. Verify Teensy can intercept and retime the pulse width accurately. Check 1N4007 flyback is correctly placed. Test with oscilloscope — you should see clean gate switching with no ringing.

07

### FIRST ECU CONNECTION — ENGINE OFF

Remove original EPROM from ECU. Install ZIF socket. Connect breadboard via ribbon cable. Disconnect fuel pump relay first (so engine cannot start accidentally). Turn ignition on — ECU should power up and attempt to read the EPROM. Logic analyzer should show address reads happening. Verify Teensy is responding. No smoke = success.

08

### FIRST START — BASIC EPROM EMULATION ONLY

Restore fuel pump relay. Start engine with Teensy serving the stock EPROM image only — no corrections active yet. Engine should run exactly as before. If it doesn't, the EPROM emulation has a timing issue. Once confirmed running, you can begin activating the sensor and correction layers one at a time.

09

### PCB DESIGN

Once all breadboard stages work reliably, transfer to KiCad. Design a single compact PCB that mounts the Teensy 4.1 on pin headers (so it's removable), the 74HCT245 ICs in DIP sockets, the LM2596 module as a sub-board, and screw terminals for all external connections. 2-layer PCB from JLCPCB — 5 boards for ~$8. This becomes your prototype PCB kit.

Sourcing notes: Amazon links provided where available. Wideband from 14point7.com direct. EPROM programmer from Amazon or AliExpress. For PCB production use JLCPCB. Prices are estimates — verify before ordering.

Ref | Component | Spec | Qty | Est. USD
── MICROCONTROLLER
U1 | Teensy 4.1 (with pins) PJRC — 600MHz ARM M7, 1MB RAM, built-in SD, USB HS, 3× CAN FD ▶ AMAZON (https://www.amazon.com/PJRC-Teensy-4-1-with-Pins/dp/B08CTM3279) | NXP iMXRT1062, FlexIO, 18× ADC, 35× PWM | 1 | ~$35
── WIDEBAND — ORDER FROM 14POINT7.COM
WB1 | Spartan 2 OEM I2C I2C VERSION 14Point7 direct — I2C digital output, no analog line, no ADC pin used ▶ 14POINT7.COM (https://www.14point7.com/collections/wideband-lambda-controllers/products/spartan-2-oem) | 0.01λ accuracy, -40°C to +125°C, 40×24mm, addr 0x01 default | 1 | $35.00
WB2 | Bosch LSU 4.9 Wideband Sensor Genuine Bosch required — clones not compatible with Spartan 2 OEM ▶ 14POINT7.COM (https://www.14point7.com/products/bosch-lsu-4-9) | Includes connector. Weld M18×1.5 bung into exhaust 18"+ from manifold | 1 | ~$45
── LEVEL SHIFTING
U2–U4 | 74HCT245 Octal Bus Transceiver DIP-20 Major Brands — confirmed working with Teensy. Avoid Todiys brand (reported failures) ▶ AMAZON (https://www.amazon.com/Tri-State-Octal-Bus-Transceiver/dp/B00GAGAZDA) | 5V Vcc, 3.3V-compatible inputs, 3-state outputs, DIP-20 | 5 | ~$6
── SENSORS
S1 | GM 3-Bar MAP Sensor OEM part # 55567257 (replaces discontinued 12592525) — with pigtail connector ▶ AMAZON (https://www.amazon.com/Sensor-Various-Models-Connector-Pigtail/dp/B07TJG9F6L) | 0–5V, 3-bar (44 PSI max), reads up to 29 PSI boost | 1 | ~$20
S2 | Bosch Knock Sensor 0261231006 Flat type, M8 mount — check if already on the 7A block before ordering ▶ AMAZON (https://www.amazon.com/Bosch-Original-Equipment-0261231006-Sensor/dp/B00BHHYVHS) | Broadband piezo, flat donut style, M8×1.25 thread | 1 | ~$28
── INJECTOR INTERCEPT
Q1–Q4 | IRLZ44N Logic-Level MOSFET (10-pack) Logic-level gate — fully on at 3.3V. TO-220 package. Need 4, buy 10 ▶ AMAZON (https://www.amazon.com/5PCS-IRLZ44NPBF-MOSFET-220AB-IRLZ44/dp/B01ARKPMPK) | N-ch, 55V, 47A, Vgs(th) ~1V — fully saturates at 3.3V gate | 1 pk | ~$6
D1–D4 | 1N4007 Flyback Diodes (100-pack) Across each injector coil — mandatory. Buy a big pack, useful everywhere ▶ AMAZON SEARCH (https://www.amazon.com/s?k=1N4007+diode+100+pack) | 1A 1000V rectifier diode | 1 pk | ~$3
── CAN BUS TRANSCEIVERS
U5–U6 | TJA1051T CAN Transceiver Module Pre-made breakout board — easiest for breadboard prototype, reuse on PCB ▶ AMAZON (https://www.amazon.com/Pcs-TJA1051T-CAN-Transceiver-Module/dp/B0G4KC3NDY) | 3V–5V compatible, 1Mbit/s, NXP TJA1051, breakout board | 2 | ~$8
── POWER REGULATION
U7 | LM2596 Buck Converter Module (5-pack) Pre-built module with LED voltmeter — set to 5V. Way easier than discrete for prototyping ▶ AMAZON (https://www.amazon.com/LM2596-Converter-3-0-40V-1-5-35V-Supply/dp/B08NV3JCBC) | 3–40V in, 1.5–35V adjustable out, 3A, LED voltmeter display | 1 pk | ~$10
U8 | AMS1117-3.3 LDO Regulator (10-pack) SOT-223 package. Input from 5V rail. Teensy VIN pin ▶ AMAZON SEARCH (https://www.amazon.com/s?k=AMS1117+3.3+SOT-223+10+pack) | 1A output, 1.3V dropout, SOT-223 | 1 pk | ~$4
D5 | P6KE15A TVS Diode Automotive load-dump spike protection — not optional on a car! ▶ AMAZON SEARCH (https://www.amazon.com/s?k=P6KE15A+TVS+diode) | 600W transient, 15V clamp, DO-15 package | 5 | ~$3
D6 | 1N5822 Schottky 3A Diode (10-pack) Reverse polarity protection on 12V input ▶ AMAZON SEARCH (https://www.amazon.com/s?k=1N5822+schottky+diode) | 40V 3A Schottky, low forward drop | 1 pk | ~$3
── EPROM SOCKET + PROGRAMMING
J1 | 28-Pin ZIF Socket (5-pack) Replaces EPROM in ECU socket. Buy several — useful for prototyping ▶ AMAZON (https://www.amazon.com/28-pin-Pins-Universal-Socket-Narrow/dp/B01N3P502V) | Narrow DIP-28, 2.54mm pitch, zero insertion force | 1 pk | ~$8
PROG | TL866II+ / T48 EPROM Programmer READ THE ORIGINAL EPROM BEFORE ANYTHING ELSE — this is your safety net ▶ AMAZON SEARCH (https://www.amazon.com/s?k=TL866II+EPROM+programmer) | Supports TC537000P and most EPROM types, USB to PC | 1 | ~$35
── PASSIVES + PROTOTYPING
C-KIT | Capacitor Assortment Kit ▶ AMAZON SEARCH (https://www.amazon.com/s?k=capacitor+assortment+electrolytic+ceramic) | 100µF/25V electro, 10µF tantalum, 0.1µF + 100pF ceramic | 1 kit | ~$8
R-KIT | Resistor Kit (600pc) ▶ AMAZON SEARCH (https://www.amazon.com/s?k=resistor+assortment+kit+600) | 10kΩ, 20kΩ, 100kΩ, 100Ω, 1kΩ needed for dividers + gate resistors | 1 kit | ~$8
BB | 830-Point Breadboards (2-pack) ▶ AMAZON SEARCH (https://www.amazon.com/s?k=830+point+breadboard+2+pack) | Full size, 830 tie points, for prototype build | 1 pk | ~$8
WIRE | Jumper Wire Kit 120pc ▶ AMAZON SEARCH (https://www.amazon.com/s?k=dupont+jumper+wire+120+male+female) | M-M, M-F, F-F assortment, Dupont 2.54mm | 1 kit | ~$7
FUSE | Weatherproof Inline Fuse Holder + 5A Fuses ▶ AMAZON SEARCH (https://www.amazon.com/s?k=waterproof+inline+blade+fuse+holder+automotive) | ATO blade type, 12V rated, waterproof housing | 2 | ~$6
── PCB (AFTER PROTOTYPE CONFIRMED WORKING)
PCB | Custom PCB via JLCPCB Design in KiCad (free). 5 boards, 2-layer, ~80×60mm. Green or black soldermask ▶ JLCPCB.COM | 2-layer, ENIG finish recommended for kit resale. ~10 day turnaround | 5 | ~$10
ESTIMATED PROTOTYPE TOTAL excl. wideband sensor | | | | ~$165
ESTIMATED PROTOTYPE TOTAL incl. wideband + sensor | | | | ~$245
vs AEM wideband option from v1 schematic — saving ~$75 and gaining I2C digital output | | | | ✓ BETTER
