dspl1236/TeensyEprom/schematics/audi90_teensy_lite_wiring.html

// AUDI 90 TEENSY ECU INTERFACE · LITE v1.0 · PROTOTYPE WIRING

# EPROM EMULATOR // BREADBOARD WIRING REFERENCE

TEENSY 4.1 CENTRE · 74HCT245 ×3 · 27C256 DIP-28 SOCKET · POWER+GND BUS BAR

RED — 5V power bus

BLACK — GND bus

ORANGE — Data D0–D7

CYAN — Addr low A0–A7

GREEN — Addr high A8–A14

PURPLE — Control /OE /CE

YELLOW — DIR

STEP 1 — POWER & GND BUS BARS

Source | Signal | Bus bar | Tapped to | Wire
Socket pin 28 | 5V Vcc | Red bar top | Teensy VIN · U2/U3/U4 Vcc (pin 20) | RED
Socket pin 14 | GND | Black bar bottom | Teensy GND · U2/U3/U4 GND (pin 10) | BLACK

Bus bars: Lay a full-length wire across the board first — red at top, black at bottom. Then tap vertical wires down/up to each component Vcc/GND pin. Add 0.1µF ceramic bypass cap between Vcc and GND on each 74HCT245.

STEP 2 — DATA BUS D0–D7 (DIP → U2 → Teensy T2–T9)

Socket Pin | Signal | U2 A-side | U2 B-side | Teensy | Wire
11 (L) | D0 | A1 | B1 | 2 | ORANGE
12 (L) | D1 | A2 | B2 | 3 | ORANGE
13 (L) | D2 | A3 | B3 | 4 | ORANGE
15 (R) | D3 | A4 | B4 | 5 | ORANGE
16 (R) | D4 | A5 | B5 | 6 | ORANGE
17 (R) | D5 | A6 | B6 | 7 | ORANGE
18 (R) | D6 | A7 | B7 | 8 | ORANGE
19 (R) | D7 | A8 | B8 | 9 | ORANGE

U2 B→Teensy: Perfectly horizontal wires — U2 rows and Teensy data pads are at the same Y. U2 config: DIR (pin 1) → T29 · /OE (pin 19) → GND.

STEP 3 — ADDR LOW A0–A7 (DIP → U3 → Teensy T10–T17, T36)

Socket Pin | Signal | U3 A-side | U3 B-side | Teensy | Wire
10 (L) | A0 | A1 | B1 | 10 | CYAN
9 (L) | A1 | A2 | B2 | 11 | CYAN
8 (L) | A2 | A3 | B3 | 12 | CYAN
7 (L) | A3 | A4 | B4 | 14 | CYAN
6 (L) | A4 | A5 | B5 | 15 | CYAN
5 (L) | A5 | A6 | B6 | 16 | CYAN
4 (L) | A6 | A7 | B7 | 17 | CYAN
3 (L) | A7 | A8 | B8 | 36 | CYAN

U3 config: DIR (pin 1) → 5V · /OE (pin 19) → GND. T13 skip: A3 → T14. A7 → T36 (bottom pad).

STEP 4 — ADDR HIGH A8–A14 + /CE (DIP → bottom channel → U4 → Teensy T18–T25)

Socket Pin | Signal | U4 A-side | U4 B-side | Teensy | Wire
25 (R) | A8 | A1 | B1 | 18 | GREEN
24 (R) | A9 | A2 | B2 | 19 | GREEN
21 (R) | A10 | A3 | B3 | 20 | GREEN
23 (R) | A11 | A4 | B4 | 21 | GREEN
2 (L) | A12 | A5 | B5 | 22 | GREEN
26 (R) | A13 | A6 | B6 | 23 | GREEN
1 (L) | A14 | A7 | B7 | 24 | GREEN
20 (R) | /CE | A8 | B8 | 25 | PURPLE

Routing: Addr-high wires drop below the GND bus bar, fan across to U4, then rise via 45° into U4 A-side inputs. U4 config: DIR (pin 1) → 5V · /OE (pin 19) → GND. U4 B-side → Teensy: Horizontal wires at matching Y.

STEP 5 — /OE DIVIDER + DIR

From | Via | To | Wire | Notes
Socket pin 22 (/OE) | 10kΩ series | Teensy T26 | PURPLE dashed | 5V×20k÷30k = 3.33V ✓
After 10k junction | 20kΩ to GND | GND bus | PURPLE | Pull-down
Teensy T29 | direct | U2 DIR (pin 1) | YELLOW dashed | Firmware LOW = Teensy drives ECU

NOT CONNECTED

Pin | Signal | Action
Socket pin 27 | WE | Leave open — programming only
Teensy pin 13 | LED | Skip — A3 uses pin 14

BUILD CHECKLIST

Power + Bus Bars

Lay 5V bus bar (red) across top

Lay GND bus bar (black) across bottom

Sk28 → 5V bar · Sk14 → GND bar

Tap 5V → Teensy VIN

Tap GND → Teensy GND

Tap 5V → U2 pin 20 (Vcc)

Tap 5V → U3 pin 20 (Vcc)

Tap 5V → U4 pin 20 (Vcc)

Tap GND → U2 pin 10

Tap GND → U3 pin 10

Tap GND → U4 pin 10

5V → U3 DIR (pin 1)

5V → U4 DIR (pin 1)

GND → U2/U3/U4 /OE (pin 19)

0.1µF bypass cap on each chip

Verify 3.3V on Teensy 3V3 pad

Data + Addr Low

Sk11 D0 → U2-A1 → T2

Sk12 D1 → U2-A2 → T3

Sk13 D2 → U2-A3 → T4

Sk15 D3 → U2-A4 → T5

Sk16 D4 → U2-A5 → T6

Sk17 D5 → U2-A6 → T7

Sk18 D6 → U2-A7 → T8

Sk19 D7 → U2-A8 → T9

T29 → U2 DIR (pin 1)

Sk10 A0 → U3-A1 → T10

Sk9 A1 → U3-A2 → T11

Sk8 A2 → U3-A3 → T12

Sk7 A3 → U3-A4 → T14

Sk6 A4 → U3-A5 → T15

Sk5 A5 → U3-A6 → T16

Sk4 A6 → U3-A7 → T17

Sk3 A7 → U3-A8 → T36

Addr High + Control

Sk25 A8 → bottom ch → U4-A1 → T18

Sk24 A9 → bottom ch → U4-A2 → T19

Sk21 A10 → bottom ch → U4-A3 → T20

Sk23 A11 → bottom ch → U4-A4 → T21

Sk2 A12 → bottom ch → U4-A5 → T22

Sk26 A13 → bottom ch → U4-A6 → T23

Sk1 A14 → bottom ch → U4-A7 → T24

Sk20 /CE → bottom ch → U4-A8 → T25

Sk22 /OE → 10k → T26 (+ 20k→GND)

Sk27 WE = NOT CONNECTED

POWER FIRST: Bus bars before any signal wires. Tap 5V and GND to Teensy, measure 3.3V on Teensy 3V3 pad before proceeding.

PIN 13 SKIP: Teensy pin 13 = onboard LED. A3 → pin 14. A7 → pin 36 (bottom of board).

ADDR HIGH ROUTING: These wires drop below the GND bus bar into the bottom channel (8 stacked lanes). Each wire has its own lane — use the colour to trace it back to the correct DIP pin.
