dspl1236/TeensyEprom/firmware/src/corrections.h

#pragma once
// corrections.h — closed-loop fuel trim and knock retard

void  corrections_init();
void  corrections_update(uint8_t* romData);
float corrections_getFuelTrim();
float corrections_getKnockRetard();
