dspl1236/TeensyEprom/(commit log)

2026-03-09 Initial commit - schematics, ROMs, BOM, project notes
2026-03-10 Add firmware - EPROM emulator, wideband, corrections engine
    [config.h, corrections.cpp, eprom_emu.h, main.cpp, modules.h, wideband.cpp]
2026-03-10 Add MAF intercept - Phase 1 freq correction + Phase 2 1.8T analog translation
    [config.h, maf.cpp, maf.h]
2026-03-10 Schematic v0.4 - MAF Phase 1/2 architecture, VR6/225 housing, 1.8T sensor BOM
2026-03-10 feat: 3-mode architecture - ROM Tool / Teensy Full / Teensy Lite, firmware flash, map switcher
2026-03-10 fix: add missing firmware headers, exclude lite/ from full build
    [can_bus.h, corrections.h, sensors.h, wideband.h]
2026-03-10 fix: add Arduino.h + config.h includes to all firmware headers
    [corrections.cpp, sensors.h, wideband.h]
2026-03-10 fix: add config.h include to wideband.cpp
    [wideband.cpp]
2026-03-10 debug: list teensy41 build dir and find all hex files
2026-03-10 fix: set PLATFORMIO_BUILD_DIR env to force teensy41 hex into firmware/.pio
2026-03-10 fix: teensy_loader_cli download with retry, redirect follow, size check
2026-03-10 fix: use curl.exe for teensy_loader_cli download - handles redirects reliably
2026-03-11 fix(map_editor): correct axis orientation to match 034 RIP Chip tool
    Confirmed from 034 - 893906266D Stock.034 + 7A_Late_Generic_1.01.ecu:
    - Rows = RPM (Y axis), Cols = Load kPa (X axis)
    - Previous code had them transposed
    Changes:
    map_editor_tab.py:
    - Swap horizontal/vertical header labels
    - RPM_LABELS: 18 breakpoints from 034 tool (700-6300 RPM)
    - LOAD_LABELS: 16 breakpoints from 034 tool (13-100 kPa)
    - ROWS=18, COLS=16 (18x16=288 bytes per map, not 16x16=256)
    - Update UI description labels
    - Fix highlight_operating_cell() row/col lookup to match new orientation
    ecu_profiles.py:
    - 266D map defs: rows=18 cols=16 for 3 main maps
    - Update Timing map s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
    [map_editor_tab.py]
2026-03-11 fix: correct map size 256->288 and timing addr 0x1000->0x0120
    ROWS=18, COLS=16 means MAP_SIZE=288 bytes, not 256.
    Previous axis fix broke .034/.bin loading — maps showed all zeros.
    rom_manager_tab.py:
    - TIMING_MAP_ADDR 0x1000 -> 0x0120 (fuel map is 288 bytes, timing follows immediately)
    - MAP_SIZE = ROWS * COLS constant (288)
    - load_data() slices [:256] -> [:MAP_SIZE]
    - get_data() already used ROWS/COLS correctly
    - Fix tab labels: Rows=RPM, Cols=Load kPa (18x16)
    protocol.py:
    - Import ROWS, COLS from map_editor_tab, derive MAP_SIZE
    - MAP:FUEL and MAP:TIMING length guards 256 -> MAP_SIZE
    - Log wrong-length map responses instead of silently dropping
    - Update docstring: 256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
    [protocol.py, rom_manager_tab.py]
2026-03-11 docs(version): document semver convention in version.py
    MAJOR — manual only (milestone/breaking)
    MINOR — new features
    PATCH — bug fixes and corrections
2026-03-11 feat: v1.5.0 — correct .034 unscramble + true fuel formula from Java source
    Source of truth: decompiled 034EFI_Rip_Chip_1_0_0_Hitachi.msi ECUGUI.jar
    CRITICAL FIXES (all previous formula work was wrong):
    - .034 files are BIT-SCRAMBLED — algOne() must be applied to every byte
    before any map data is usable:
    step1 = swap odd/even bits (algZero: byte & 0xAA >> 1 | byte & 0x55 << 1)
    step2 = swap nibbles (bSwap: step1 >> 4 | step1 << 4)
    Added unscramble_byte() / unscramble_rom() to ecu_profiles.py
    - Fuel map display formula (from ArrayStuff.factorAndOffset):
    display = signed(native_byte) + 128
    (dataFactor=1.0, dataOffset=128.0, dataSigned=true)
    Stock map range: 40–12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
    [map_editor_tab.py, protocol.py, rom_manager_tab.py]
2026-03-11 feat: v1.7.0 — additional map tabs + Save As only
    New ROM editor tabs:
    Fuel Map — unchanged (16×16, version-aware formula)
    Timing Map — unchanged (16×16, degrees BTDC)
    Knock Timing — NEW (16×16 at 0x1000, same timing formula)
    Scalars & 1-D — NEW:
    - Injection Scaler (0x077E, raw byte, display=raw×0.3922)
    - CL Disable RPM (0x07E1, display=raw×25, enter RPM directly)
    - Decel Cutoff (1×16 at 0x0E30, kPa values)
    - CL Load Limit (1×16 at 0x0660)
    MAF Lin (266B) — NEW, shown only for 266B
    - 64×16-bit big-endian values at 0x02D0
    Helper widgets added above OfflineRomEditor:
    _ScalarEdit — single-value QSpinBox with dark styling
    _OneDTa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
2026-03-11 docs: update CREDITS.md — acknowledge 034 no longer supports old ECUs, add community purpose statement
2026-03-11 fix: correct per-map axis labels — timing RPM axis differs from fuel RPM axis
    Both ECUs have separate RPM axes for the fuel and timing maps:
    Fuel RPM axis @ 0x0250: starts 600/800 (266D and 266B differ in midrange)
    Timing RPM axis @ 0x0270: starts 700/750 (identical on both ECUs)
    Previously all maps used RPM_AXIS_266D (600/800 start) — timing and knock
    maps were showing the wrong row labels. Now matches 034 RipChip exactly.
    Also confirmed 266B fuel RPM axis differs from 266D:
    266D: 600,800,1000,1250,1500,1750,2000,2250,2500,2750,3000,3500,4000,5000,6000,6300
    266B: 600,800,1000,1250,1500,2000,2500,2750,3000,3500,4000,4500,5000,5500,6000,6375
    (266B skips 1750 and 2250, ends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
    [map_editor_tab.py, rom_manager_tab.py]
2026-03-11 feat: add V6 AAH 12v ECU support (MMS-200)
    New ECU version 'AAH' covering the Audi/VW 12v V6 AAH engine
    using the MMS-200 Hitachi ECU (same 034 Rip Chip platform).
    Confirmed from decoded stock + Stage1 ROMs and parsed .ecu file:
    ROM MAP LAYOUT:
    0x0000 Fueling Map 16×16 signed+128 (same formula as 266D, stock 78–141)
    0x0100 Timing Map 16×16 degrees BTDC (stock 0–36°)
    0x077E Injection Scaler scalar (stock=100, same address as 7A)
    0x07E1 CL Disable RPM scalar ×25=RPM (stock 244=6100 RPM)
    0x0E30 Decel Cutoff 1×16 ×0.3922=kPa
    0x1000 Timing Map Knock 16×16 degrees BTDC
    AXIS BREAKPOINTS (at ROM 0x0270/0x0280 — same address as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
2026-03-11 fix: correct AAH fuel formula and checksum region
    Two bugs found by comparing against 034 RipChip tool screenshot:
    1. FUEL FORMULA: AAH uses Lambda (signed×0.007813+1.0), NOT signed+128.
    Same formula as 266B. Confirmed cell-for-cell against Stage1 fuel map
    display in screenshot (100% load row: 1.063, 1.102, 1.047, 1.219... ✓)
    - rom_manager_tab: AAH now uses raw_to_lambda/lambda_to_raw (load + save)
    - ecu_profiles: MapDef description corrected
    2. CHECKSUM REGION: FROM=0x6700 TO=0x7D1E (per .ecu 'Correction Area' fields)
    Previous code used 0x6AE6-0x6AFE (too narrow — just where Stage1 happened
    to place correction bytes, not the full allowed region).
    Both stock and S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
    [rom_manager_tab.py]
2026-03-11 feat: timing map signed-degree heat map + tooltip
    Wasted-spark ECUs (AAH V6) use wrap-around unsigned bytes for timing
    retard: values >128 mean negative BTDC (e.g. 251 = -5°, 255 = -1°).
    The old colour scale treated 251 as "almost max" → bright red, which
    was completely misleading.
    - New _timing_color() in map_editor_tab: signed-aware colour scale
    anchored to -10°→+40° BTDC. Retard values render blue/cold,
    full advance renders red/hot.
    - MapTable now tracks _is_timing flag (map_type in timing/knock)
    and routes through _timing_color() instead of _interpolate_color().
    - Hover tooltip on every timing/knock cell shows signed interpretation:
    "251 → -5° (retard)" or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
2026-03-12 docs: add physical chip read + comprehensive 266D ROM map
    Physical chip read:
    - Source: MMS-05C HF201Y43 desoldered from Hitachi GE002336-2 (266D)
    - Chip: 27C256A-20-XG (32KB — confirms ROM_ACTIVE_SIZE=32768 is correct)
    - CRC32: 0x4152E167 — added to KNOWN_ROMS fingerprint table
    - Fuel/timing map cores match 034 stock exactly
    - 1098 bytes differ: decel region, CL load limit, 0x0C00 area, scalars
    - Previous tune was on this chip (not OEM stock, not 034 stock file)
    - README.md documents full diff analysis
    ROM_MAP_266D.md — comprehensive address map:
    - 14 confirmed maps (fuel, timing, axes, scalars)
    - 20+ undocumented regions identified from ROM scan:
    - MAF linearization at 0x02D0 (32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
2026-03-12 docs: add prototype wiring reference with visual diagram
    Wire-by-wire build guide for breadboard prototype:
    - Visual SVG layout showing DIP-28 socket, 3x 74HCT245, Teensy 4.1
    - Colour-coded by signal group (red/black/orange/cyan/green/purple/yellow)
    - Step-by-step tables: power → data bus → addr low → addr high → /OE → DIR
    - Full printable checklist with 60-joint count
    - Pin 13 (onboard LED) conflict noted — A3 routes to pin 14, A7 to pin 36
    - /OE voltage divider (10k/20k) documented with resistor symbol
    - NC: socket pin 27 (WE) explicitly called out
2026-03-12 docs: clean lane-routed wiring diagram — no wire overlaps
2026-03-12 docs: redesign wiring diagram with 45deg routing, full spacing
2026-03-12 docs: redesign wiring diagram — Teensy centre, bus bars, 45deg routing
2026-03-12 feat: v1.10.0 — physical chip as default base ROM, AAH MMS-100, expanded base ROM library
    - Add rom_files/base_roms/ with two genuine physical chip reads:
    - 266D_MMS05C_physical_stock.bin (CRC 0x4152E167) — true OEM, no idle tweaks
    - AAH_MMS100_4A0906266_stock.bin (CRC 0x6875638D) — Audi 100/A6 AAH variant,
    more aggressive timing (+2-4 deg peak) vs MMS-200
    - Hardware tab BASE_ROMS: 266D_PHYSICAL is now default (★ RECOMMENDED)
    - BASE_ROMS expanded: 266D physical, 266D 034 stock, 266D S2, 266B stock,
    266B S2, AAH MMS-100, AAH MMS-200, AAH S1, Custom
    - _load_builtin_rom: supports both base_roms/*.bin and 034_rip_chip/*.034
    - AAH base displacement auto-sets to 2771cc; 7A defaul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
2026-03-12 fix: 27C512 save — mirror ROM into both halves, no pin mods needed
    Instead of 0xFF lower half + ROM upper half (requiring pin 1 bend to
    force A15 high), mirror the 32KB ROM into both halves of the 64KB image.
    A15 state becomes irrelevant — same data in either bank.
    Chip drops straight into the ECU socket unmodified.
    [rom_manager_tab.py]
2026-03-13 Add HachiROM as submodule — ROM detection, compare, checksum, bridge integration
    - hachirom/ submodule pointing to dspl1236/HachiROM
    - tuner_app/hachirom_init.py: adds submodule to sys.path at startup
    - tuner_app/main.py: imports hachirom_init before other modules
    - tuner_app/ui/rom_manager_tab.py: imports hachirom.bridge alongside ecu_profiles
    (HACHIROM_AVAILABLE guard — graceful fallback if submodule not initialized)
    - tuner_app/install.bat: runs git submodule update --init --recursive
    HachiROM provides: ROM detection (CRC32/reset vector), byte-level compare with
    map region tagging, checksum verify/apply, .034 unscramble, and flat map helpers
    matching the Teensy serial protocol (MAP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
    [rom_manager_tab.py]
2026-03-23 feat: v2.0 — LittleFS primary storage, CRC32 upload protocol
    Major firmware rewrite for production use:
    Storage:
    - Primary: LittleFS on Teensy 4.1 internal flash (1MB partition)
    No SD card needed — survives heat, vibration, moisture
    - Fallback: SD card checked at boot if flash is empty
    - Active map index persisted to flash across power cycles
    Upload protocol:
    - UPLOAD <filename> <size> — binary transfer over USB serial
    - CRC32 verification (4 bytes appended after data)
    - Desktop app handles chunked transfer + progress display
    Firmware (main.cpp — 680 lines):
    - LittleFS_Program for internal flash filesystem
    - ISR-based EPROM emulation unchanged (proven design)
    - Commands: INFO, L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
    [config.h, connection_panel.py, console_tab.py, corrections.cpp, corrections.h, datalog_tab.py]
2026-03-23 feat: v2.0 — LittleFS primary storage, slot-based ROM management
    Major rewrite — firmware, desktop app, and documentation.
    Firmware (main.cpp):
    - LittleFS on program flash as primary ROM storage (1MB partition)
    - 16 numbered slots (slot_00.bin through slot_15.bin)
    - USB serial upload protocol: UPLOAD <slot> <size> + binary data
    - SD card fallback: auto-imports .bin files from maps/ on first boot
    - Persistent active slot tracking via /active.txt
    - Slot-aware button cycling (skips empty slots)
    - New commands: UPLOAD, DELETE, IMPORT, FORMAT
    Config (config.h):
    - LittleFS partition size and slot config added
    - SD card paths moved to fallback section
    - Power section clarified: DIP-28 Vcc →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
    [config.h, main.cpp, teensy_eprom.py]
2026-03-23 docs: update README and build guide for v2.0 LittleFS-primary
    - README: LittleFS primary storage, SD card optional fallback,
    updated quick start (upload via USB, no SD required),
    serial command reference includes UPLOAD/DOWNLOAD/DELETE/FORMAT
    - LITE_BUILD: full rewrite — LittleFS storage section, updated
    boot sequence, desktop app usage, workflow section
    - SD card listed as optional in BOM
2026-03-23 feat: CI builds Windows EXE + firmware hex, SVG wiring schematic
    CI:
    - Rewritten for TeensyEprom v2.0 — builds firmware .hex + Windows
    .exe (PyInstaller, pyserial bundled) + rolling GitHub release
    - Removed legacy Audi90Tuner/PyQt5 build references
    Schematic:
    - teensy_eprom_wiring.svg — standalone SVG with color-coded signal
    groups (5V address, 3.3V address, data direct, control/resistors,
    power), DIP-28 pinout, 74HCT245 mapping, Teensy pin assignments
    .gitignore: added PyInstaller build artifacts
2026-03-23 docs: complete pin-by-pin wiring tables in LITE_BUILD.md
    Every connection is now an explicit row: U1/U2 DIP-20 pin number,
    function, destination, and signal name. No compressed ranges —
    wire one row, check it off, move to the next.
    Tables cover: U1 (20 pins), U2 (20 pins), data bus (8 lines),
    control signals (2 lines + resistors), power (4 connections),
    button, and bypass caps with pin numbers.
2026-03-23 fix: KiCad PCB syntax — remove comments, fix setup closure, add nets
    PCB file had ;; comments (not valid in kicad_pcb format) and
    malformed pcbplotparams nesting. Regenerated clean S-expressions.
    Added net declarations (GND, +5V, +3V3, A0-A15, D0-D7, OE, CE, BTN).
    Both files: balanced parens verified.
    [TeensyEprom.kicad_pcb, TeensyEprom.kicad_sch]
2026-03-23 fix: PCB file — complete pcbplotparams block (KiCad parse error)
    [TeensyEprom.kicad_pcb]
